TheMarkster/RADAR/(list of files, cad)

Other CAD files:
radar.dxf
