TheMarkster/RADAR/power_supply.brd

## EAGLE design power_supply.brd (2015-05-27)

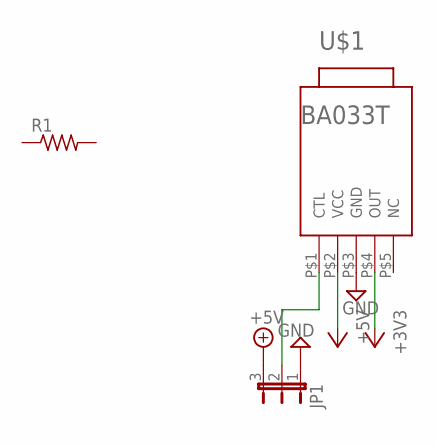
[picture p1: schematic power_supply.sch]

Parts:
JP1: JP2E; JP2
R1: R-US_R0603; R0603
U$1: BA033T; TO220FP-5

Connections:
+3V3: U$1.P$4 (OUT)
+5V: JP1.3, U$1.P$2 (VCC)
GND: JP1.1, U$1.P$3 (GND)
unnamed: JP1.2, U$1.P$1 (CTL)

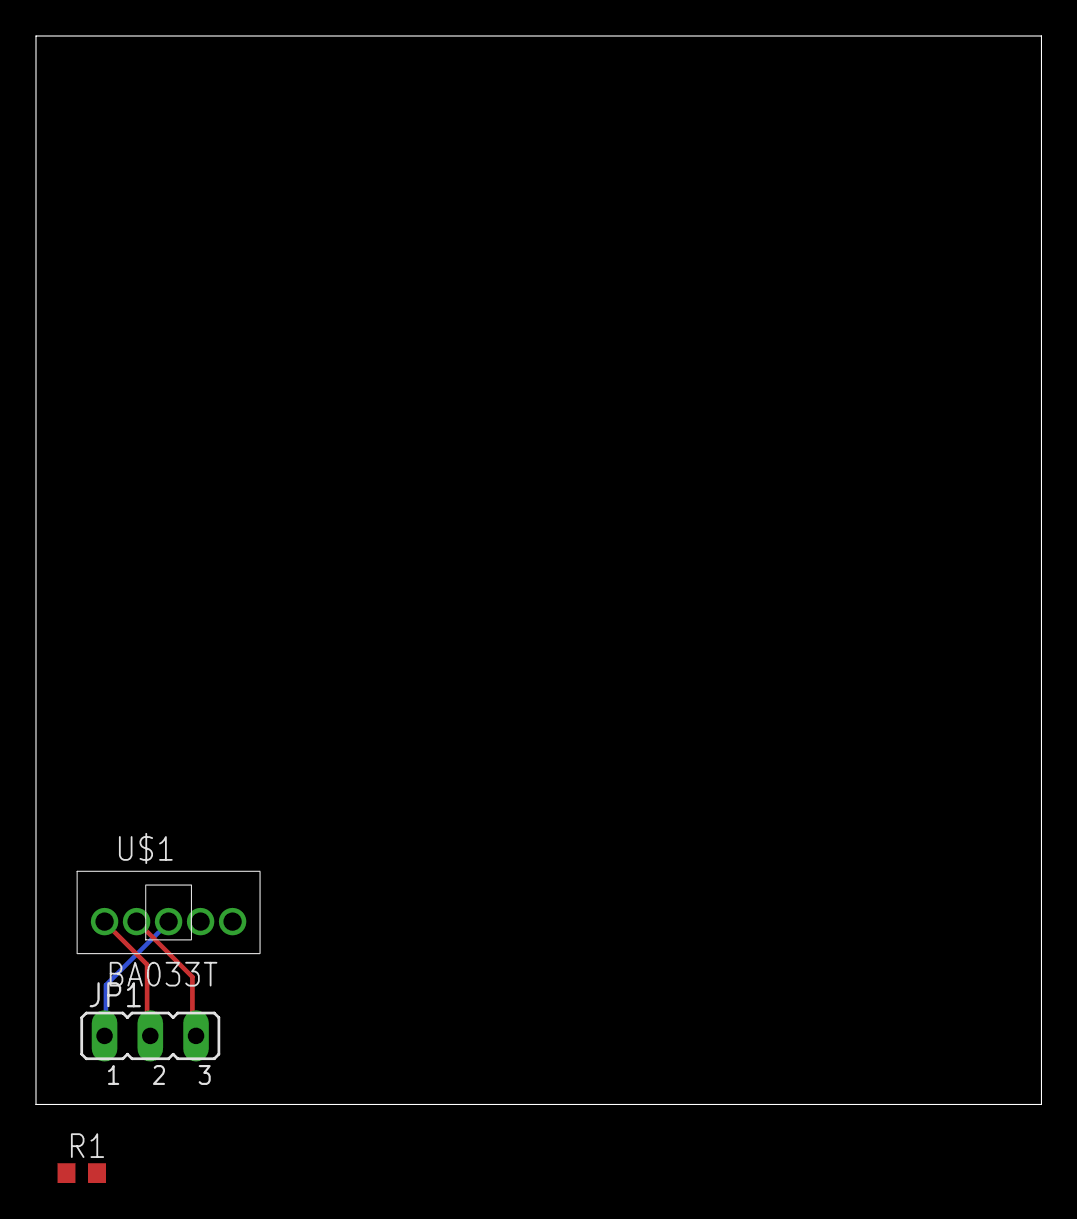
[picture p2: board power_supply.brd from above]

Board: 2 copper layers, 55.9 x 59.4 mm, 3 parts (0 on the bottom side), 3 nets.
