TheMarkster/RADAR/radar.brd

## EAGLE design radar.brd (2015-05-27)

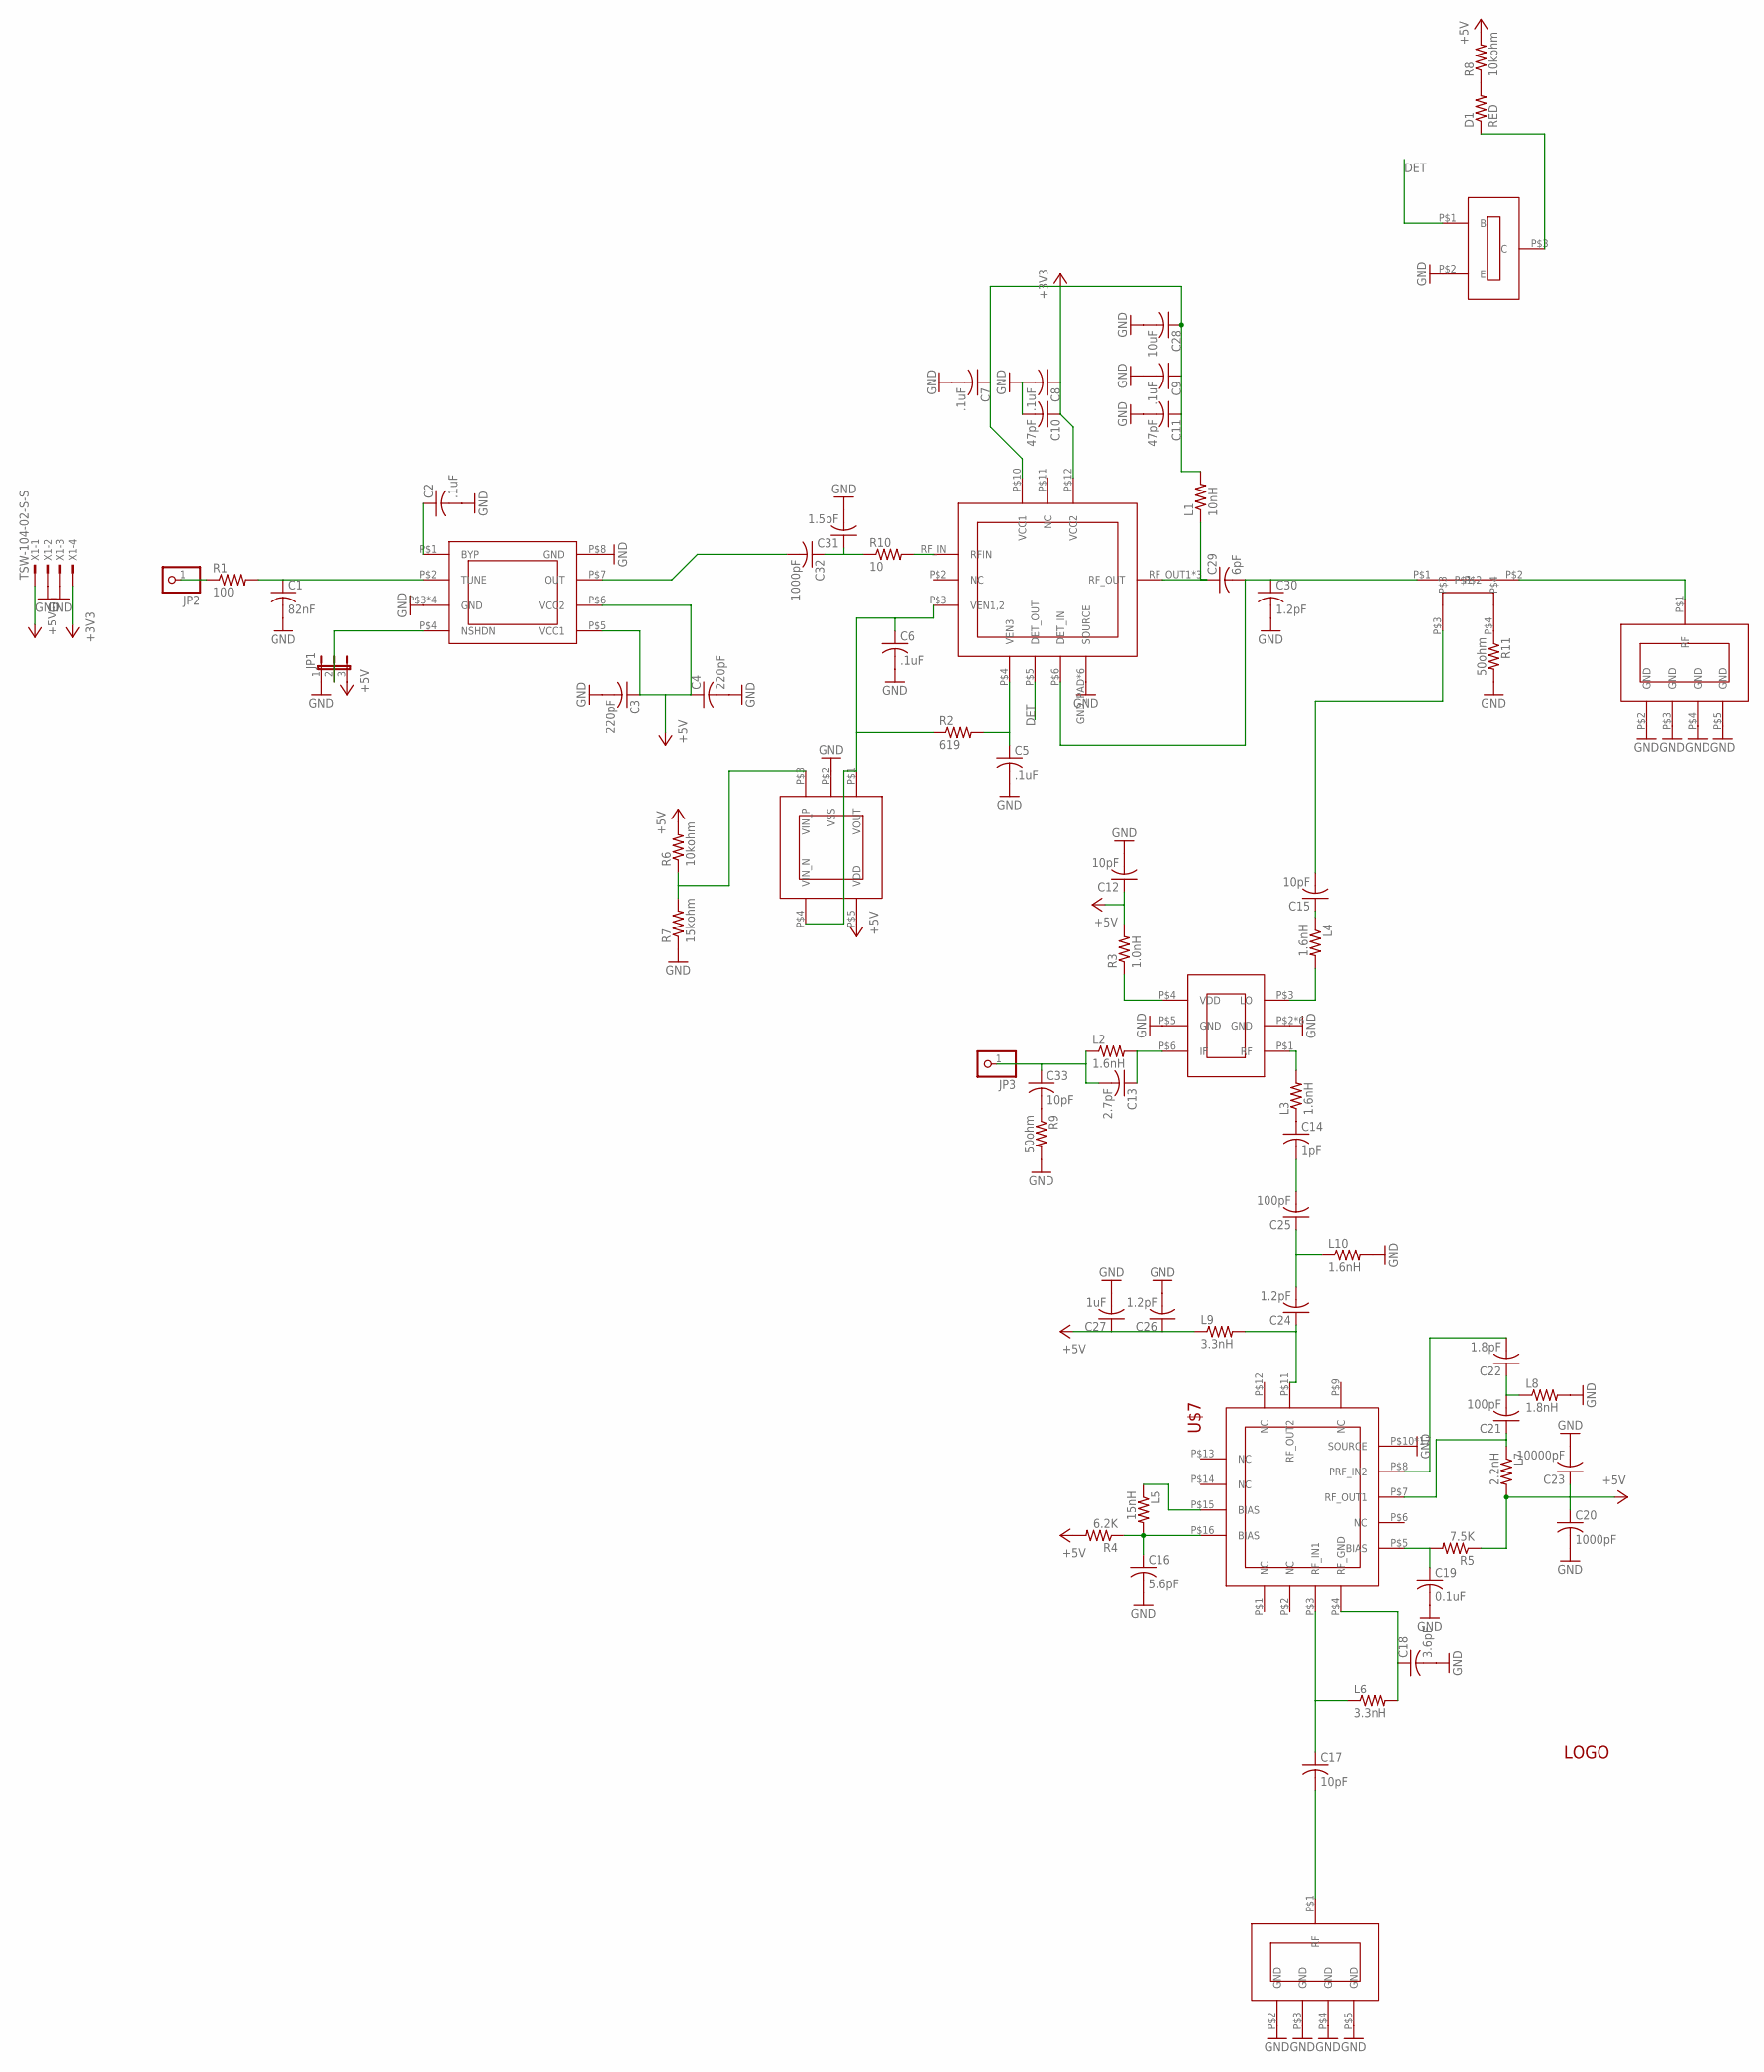
[picture p3: schematic radar.sch]

Parts:
C1: 82nF; C3216; PART# VJ1206Y823MXBTW1BC
C2, C5, C6, C7, C8, C9: .1uF; C0805; PART# VJ0805Y104MXXAC
C3, C4: 220pF; C0805; PART# VJ0805A221JXAPW1BC
C10, C11: 47pF; C0805; PART# VJ0805A470GXACW1BC
C12: 10pF; C0805; PART# VJ0603A100JXACW1BC
C13: 2.7pF; C0603; PART# VJ0603A2R7CXACW1BC
C14: 1pF; C0603; PART# VJ0603A1R0CXACW1BC
C15: 10pF; C0603; PART# VJ0603A2R7CXACW1BC
C16: 5.6pF; C0603; PART# VJ0603A5R6CXACW1BC
C17: 10pF; C0603; PART# VJ0603A100JXACW1BC
C18: 3.6pF; C0603; PART# VJ0603A3R9CXACW1BC
C19: 0.1uF; C0603; PART# VJ0603A3R9CXACW1BC
C20: 1000pF; C0603; PART# VJ0603A3R9CXACW1BC
C21, C25: 100pF; C0603; PART# VJ0603A3R9CXACW1BC
C22: 1.8pF; C0603; PART# VJ0603A3R9CXACW1BC
C23: 10000pF; C0603; PART# VJ0603A3R9CXACW1BC
C24, C26: 1.2pF; C0603; PART# VJ0603A3R9CXACW1BC
C27: 1uF; C0603; PART# VJ0603A3R9CXACW1BC
C28: 10uF; C1206; PART# VJ1206V106ZXQTW1BC
C29: 6pF; C0603; PART# VJ0805Y104MXXAC
C30: 1.2pF; C0603; PART# VJ0805Y104MXXAC
C31: 1.5pF; C0603K; PART# VJ0805Y104MXXAC
C32: 1000pF; C0603K; PART# VJ0805Y104MXXAC
C33: 10pF; C0805; PART# VJ0805A100GXAPW1BC
D1: RED; R1206; PART# VJ1206Y823MXBTW1BC
JP1: JP2E; JP2
JP2, JP3: PINHD-1X1; 1X01
L1: 10nH; R0603; PART# HK060310NJ-T
L2, L3, L4, L10: 1.6nH; R0603; PART# HK060310NJ-T
L5: 15nH; R0603; PART# HK160815NJ-T
L6, L9: 3.3nH; R0603; PART# HK16083N3S-T
L7: 2.2nH; R0603; PART# HK16083N3S-T
L8: 1.8nH; R0603; PART# HK16083N3S-T
R1: 100; R1206; PART# VJ1206Y823MXBTW1BC
R2: 619; R0805; PART# CRCW0805619RFKEA
R3: 1.0nH; R0402; PART# ILC0402ER1N0S
R4: 6.2K; R0603; PART# CRCW06036K20FKEA
R5: 7.5K; R0603; PART# CRCW06036K20FKEA
R6, R8: 10kohm; R1206; PART# VJ1206Y823MXBTW1BC
R7: 15kohm; R1206; PART# VJ1206Y823MXBTW1BC
R9, R11: 50ohm; R0805; PART# CRCW080550R0FKTA
R10: 10; R0603; PART# CRCW0805619RFKEA
U1: MAX2750
U$1: COUPLER
U$2: MAAPSS0075; MAAPSS075
U$3: CMY210
U$4, U$6: SMA
U$7: SKY67107
U$9: MCP6001; SOT-23-5
U$10: MMBT3904; SOT23-3
U$11: LOGO
X1: TSW-104-02-S-S

Connections:
+3V3: C7.1, C8.1, C9.1, C10.1, C11.1, C28.1, L1.2, U$2.P$10 (VCC1), U$2.P$12 (VCC2), X1.4
+5V: C3.1, C4.1, C12.1, C20.1, C23.1, C26.1, C27.1, JP1.3, L7.2, L9.1, R3.2, R4.2, R5.1, R6.2, R8.2, U1.P$5 (VCC1), U1.P$6 (VCC2), U$9.P$5 (VDD), X1.1
DET: U$2.P$5 (DET_OUT), U$10.P$1 (B)
GND: C1.2, C2.2, C3.2, C4.2, C5.2, C6.2, C7.2, C8.2, C9.2, C10.2, C11.2, C12.2, C16.2, C18.2, C19.2, C20.2, C23.2, C26.2, C27.2, C28.2, C30.2, C31.2, JP1.1, L8.2, L10.2, R7.1, R9.2, R11.2, U1.P$3 (GND), U1.P$8 (GND), U1.P$9 (GND), U1.P$11 (GND), U1.P$13 (GND), U$2.GND_PAD (SOURCE), U$2.P$1 (SOURCE), U$2.P$7 (SOURCE), U$2.P$8 (SOURCE), U$2.P$9 (SOURCE), U$2.P$14 (SOURCE), U$3.P$2 (GND), U$3.P$5 (GND), U$3.P$7 (GND), U$3.P$8 (GND), U$3.P$9 (GND), U$3.P$10 (GND), U$3.P$11 (GND), U$4.P$2 (GND), U$4.P$3 (GND), U$4.P$4 (GND), U$4.P$5 (GND), U$6.P$2 (GND), U$6.P$3 (GND), U$6.P$4 (GND), U$6.P$5 (GND), U$7.P$10 (SOURCE), U$7.P$17 (SOURCE), U$7.P$18 (SOURCE), U$7.P$19 (SOURCE), U$7.P$20 (SOURCE), U$7.P$21 (SOURCE), U$7.P$22 (SOURCE), U$7.P$23 (SOURCE), U$7.P$24 (SOURCE), U$7.P$25 (SOURCE), U$7.P$26 (SOURCE), U$7.P$27 (SOURCE), U$7.P$28 (SOURCE), U$7.P$29 (SOURCE), U$7.P$30 (SOURCE), U$7.P$31 (SOURCE), U$7.P$32 (SOURCE), U$9.P$2 (VSS), U$10.P$2 (E), X1.2, X1.3
unnamed: JP1.2, U1.P$4 (NSHDN)
unnamed: C1.1, R1.2, U1.P$2 (TUNE)
unnamed: JP2.1, R1.1
unnamed: C2.1, U1.P$1 (BYP)
unnamed: C29.1, L1.1, U$2.RF_OUT1 (RF_OUT), U$2.RF_OUT2 (RF_OUT), U$2.RF_OUT3 (RF_OUT)
unnamed: C32.2, U1.P$7 (OUT)
unnamed: C6.1, R2.1, U$2.P$3 (VEN1,2), U$9.P$1 (VOUT), U$9.P$4 (VIN_N)
unnamed: C5.1, R2.2, U$2.P$4 (VEN3)
unnamed: C29.2, C30.1, U$1.P$1, U$2.P$6 (DET_IN)
unnamed: R3.1, U$3.P$4 (VDD)
unnamed: C15.2, U$1.P$3
unnamed: C13.1, L2.2, U$3.P$6 (IF)
unnamed: C13.2, C33.1, JP3.1, L2.1
unnamed: C14.1, L3.1
unnamed: L3.2, U$3.P$1 (RF)
unnamed: L4.2, U$3.P$3 (LO)
unnamed: C15.1, L4.1
unnamed: U$1.P$2, U$4.P$1 (RF)
unnamed: D1.2, R8.1
unnamed: C16.1, L5.2, R4.1, U$7.P$16 (BIAS)
unnamed: L5.1, U$7.P$15 (BIAS)
unnamed: C17.1, L6.1, U$7.P$3 (RF_IN1)
unnamed: C18.1, L6.2, U$7.P$4 (RF_GND)
unnamed: C19.1, R5.2, U$7.P$5 (BIAS)
unnamed: C24.1, L9.2, U$7.P$11 (RF_OUT2)
unnamed: C22.2, U$7.P$8 (PRF_IN2)
unnamed: C21.2, C22.1, L8.1
unnamed: C21.1, L7.1, U$7.P$7 (RF_OUT1)
unnamed: C24.2, C25.1, L10.1
unnamed: C14.2, C25.2
unnamed: C17.2, U$6.P$1 (RF)
unnamed: C31.1, C32.1, R10.1
unnamed: R6.1, R7.2, U$9.P$3 (VIN_P)
unnamed: D1.1, U$10.P$3 (C)
unnamed: R10.2, U$2.RF_IN (RFIN)
unnamed: C33.2, R9.1
unnamed: R11.1, U$1.P$4

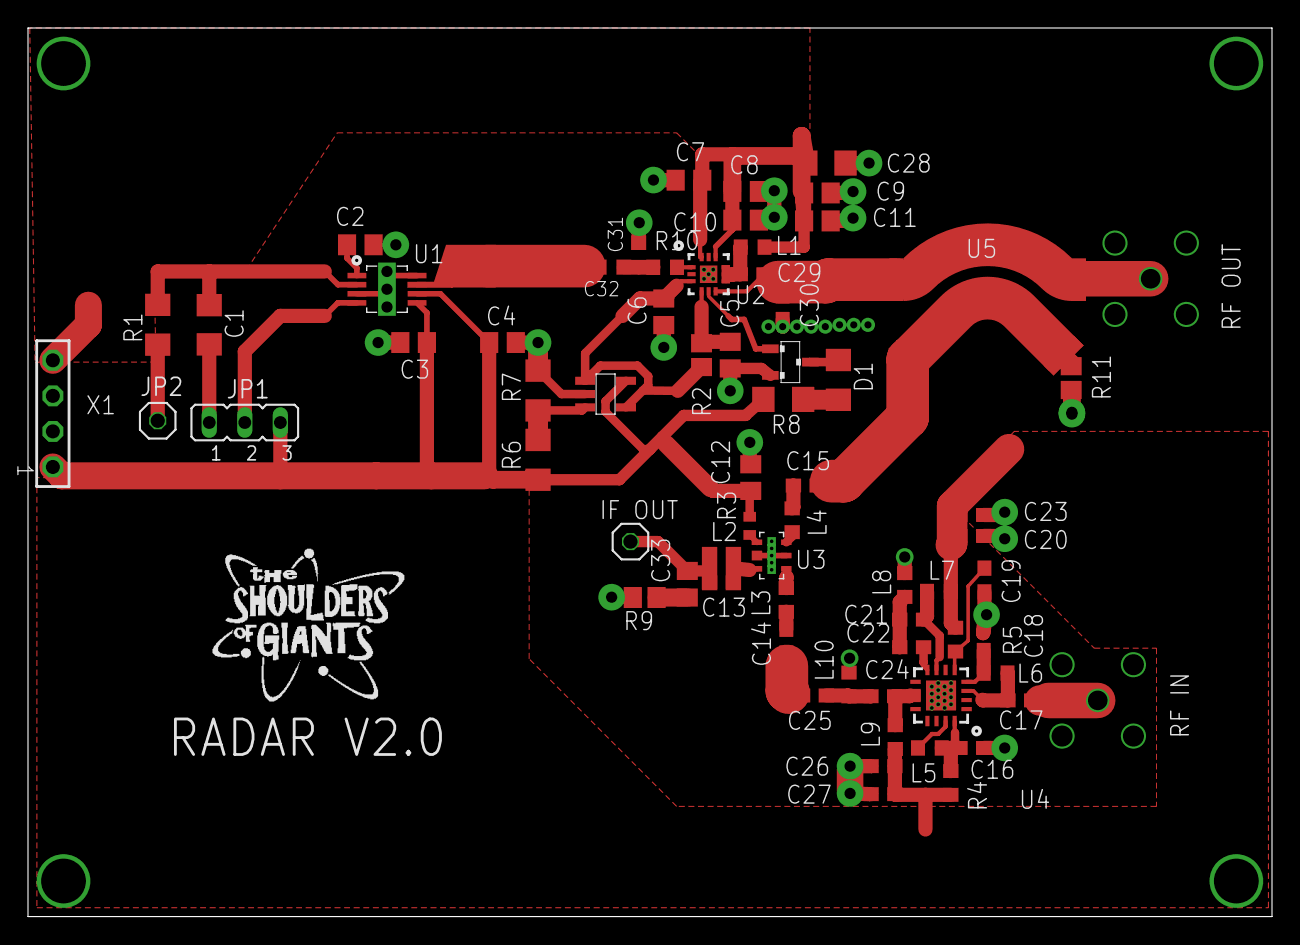
[picture p4: board radar.brd from above]

Board: 2 copper layers, 88.9 x 63.5 mm, 69 parts (0 on the bottom side), 41 nets.
